nhill03/UV-Light-Sensor/(commit log)

2017-12-04 sketch for an adafruit trinket 5V
2018-03-11 UV Sensor final project paper; data, analysis, etc
